gardner-lab/bird-monitoring/Hardware/Box_Board_Circuit.pdf

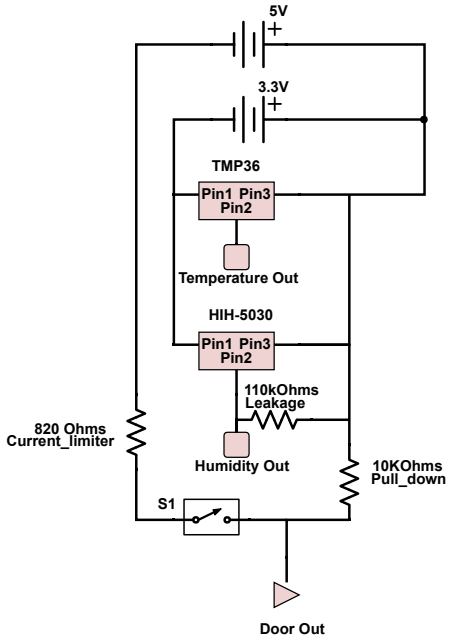
[picture p3: figure]
Pin2; Pin3; TMP36; Pin1; HIH-5030; 10KOhms Pull_down Humidity Out; Temperature Out; Door Out; 820 Ohms Current_limiter; Leakage 110kOhms
