gardner-lab/bird-monitoring/(commit log)

2016-05-04 Initial Commit
    Software is able to communicate with Arduino for fundamental data.
    Error states are non-functional. Next step is to improve error states,
    as well as the ability for the program to plot data.
    [CanaryBoxClass.pde, CanaryBoxGraphingClass.pde, CanaryBoxManager.pde, CanaryBoxManagerClass.pde, Serial_Test.ino]
2016-05-04 Revert "Initial Commit"
    This reverts commit e50d2fafcd9729e8b2a951d95089d8f2d5afef79.
    [CanaryBoxClass.pde, CanaryBoxGraphingClass.pde, CanaryBoxManager.pde, CanaryBoxManagerClass.pde, Serial_Test.ino]
2016-05-04 Revert "Revert "Initial Commit""
    This reverts commit ca60822fa8bc83e8765867aaed4f29c90a5e0f19.
    [CanaryBoxClass.pde, CanaryBoxGraphingClass.pde, CanaryBoxManager.pde, CanaryBoxManagerClass.pde, Serial_Test.ino]
2016-05-05 Graphing and Serial Fixed
    The serial communication with the Arduino is now functional, and is
    able to be extended for later use. Graphing is now supported for two
    parameters, including warning bars which will flash when passed.
    Bit-Fields have also be implemented for tracking the status of both the
    serial interface, as well as the box’s error states.
    [Serial_Test.ino]
2016-05-10 Processing Functional
    Processing code has been updated to record to .csv properly. The
    naming functionality has also been implemented. The GUI is almost
    complete, all that is needed is numerical representations for the
    temperature/humidity, and text to describe the state of the Serial
    connection. Before full functionality, all warnings must be
    implemented (such as the social time warning).
    The Arduino code has been modified to include analog reading of
    temperature and humidity for box 1. The door-close signal must be
    implemented, as well as the code for all boxes.
2016-05-16 Program Functional
    Program now has functional emailing service. Processing is now in a
    fully functional state. The Arduino code only needs to be finalized
    with the actual hardware that will be used.
2016-05-27 Update to Arduino Code
    Proper measuring of temperature.
2016-05-27 Added directory control
    The user can now pick which directory they would like to be their main
    directory, and any data being created by the program will be deposited
    into a folder “data” created in that directory. The program will
    search for the birdBoxEmailAddresses.csv file in the main directory.
    [birdBoxEmailAddresses.csv]
2016-05-27 Fixed last commit
    There was an error in uploading the last commit. Fixed.
    [CanaryBoxClass.pde, CanaryBoxHelperClasses.pde, CanaryBoxManager.pde, CanaryBoxManagerClass.pde]
2016-06-10 Updated Mail
    Updated the mail function to use port 465 instead of port 587. Added a
    label for any door-related issues (so that the user will know why the
    box is blinking red), and fixed a bug in the door-related warning check
    function.
    [birdBoxEmailAddresses.csv]
2016-06-10 Quick Fix
    Corrected debugging tool that was left in before commit.
    [CanaryBoxClass.pde]
2016-06-16 Fully Functional
    Software now is fully functional, using all three boxes, correctly
    sending emails, etc.
    [CanaryBoxCSVWriter.pde, CanaryBoxClass.pde, CanaryBoxGraphingClass.pde, CanaryBoxHelperClasses.pde, CanaryBoxManager.pde, CanaryBoxManagerClass.pde, Serial_Test.ino]
2016-06-17 ReadMe
    A ReadMe file was added, as well as certain resources for replicating
    the hardware needed for this project.
    [D-Sub_Pins.csv, Required _Hardware.csv]
2016-06-17 Minor Tweaks
    Some small changes were introduced in the code. These tweaks are
    largely untested, however. If they do not work, revert back to the
    last working commit, and notify samuelgb@bu.edu.
    [CanaryBoxCSVWriter.pde, CanaryBoxClass.pde, CanaryBoxGraphingClass.pde, CanaryBoxHelperClasses.pde, CanaryBoxManager.pde, CanaryBoxManagerClass.pde, Serial_Test.ino]
2016-06-17 Rename Required _Hardware.csv to Required_Hardware.csv
    [Required_Hardware.csv]
